Appletea404/Project_5_Balancing-Robot/images/Encoder1.JPG

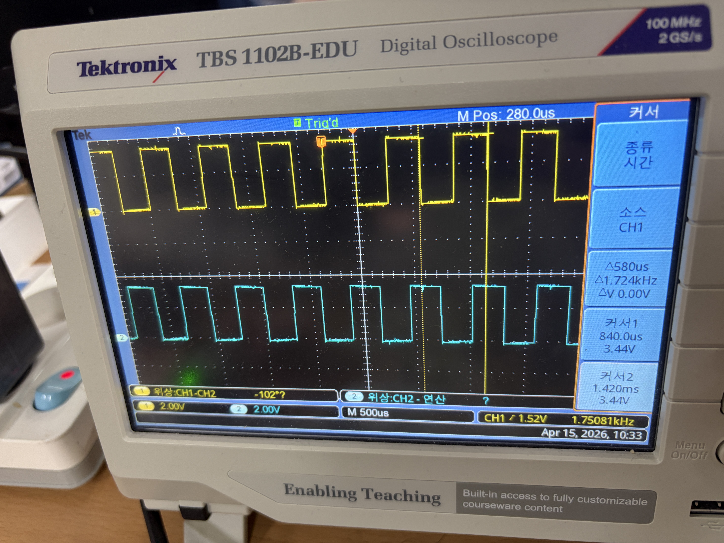
images/Encoder1.JPG
