Appletea404/Project_5_Balancing-Robot/images/Encoder2.JPG

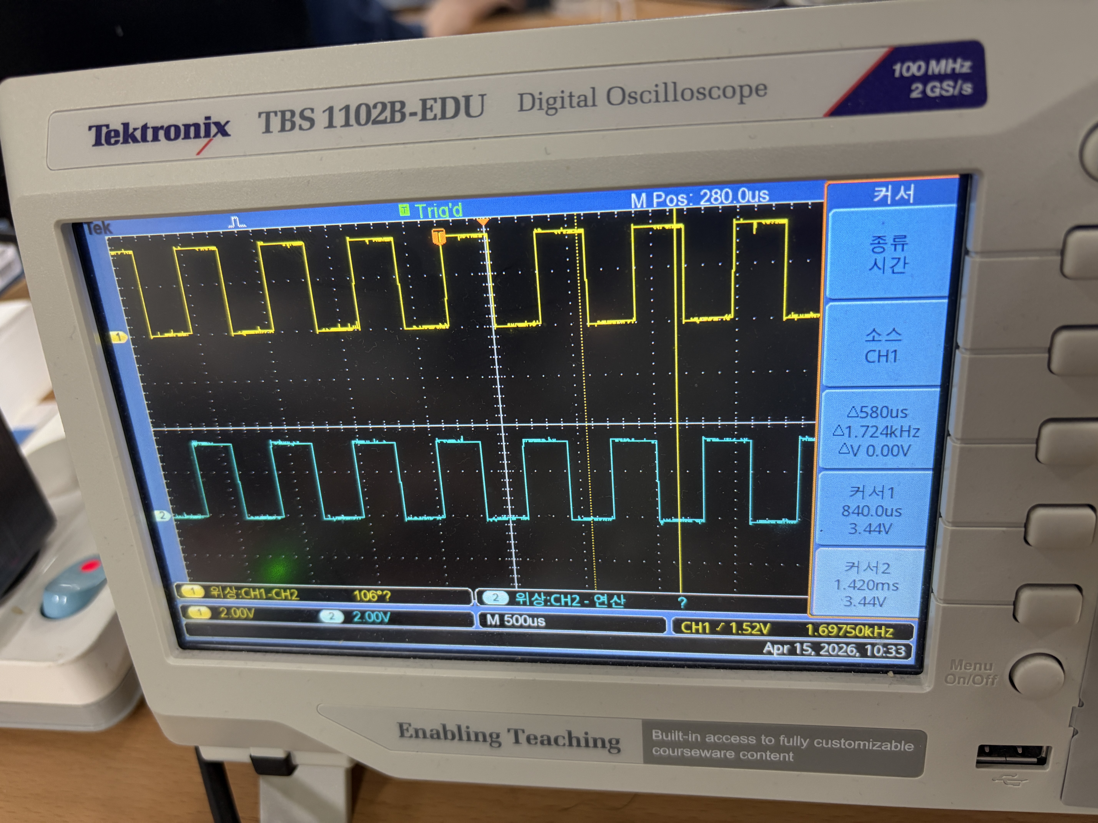
images/Encoder2.JPG
