Appletea404/Project_5_Balancing-Robot/(commit log)

2026-04-12 change basic i2c
2026-04-12 PID draft
2026-04-14 Gyro filter
2026-04-14 led to direction
2026-04-21 PID.v Adjust
