Appletea404/Project_5_Balancing-Robot/images/Motor_Driver.jpg

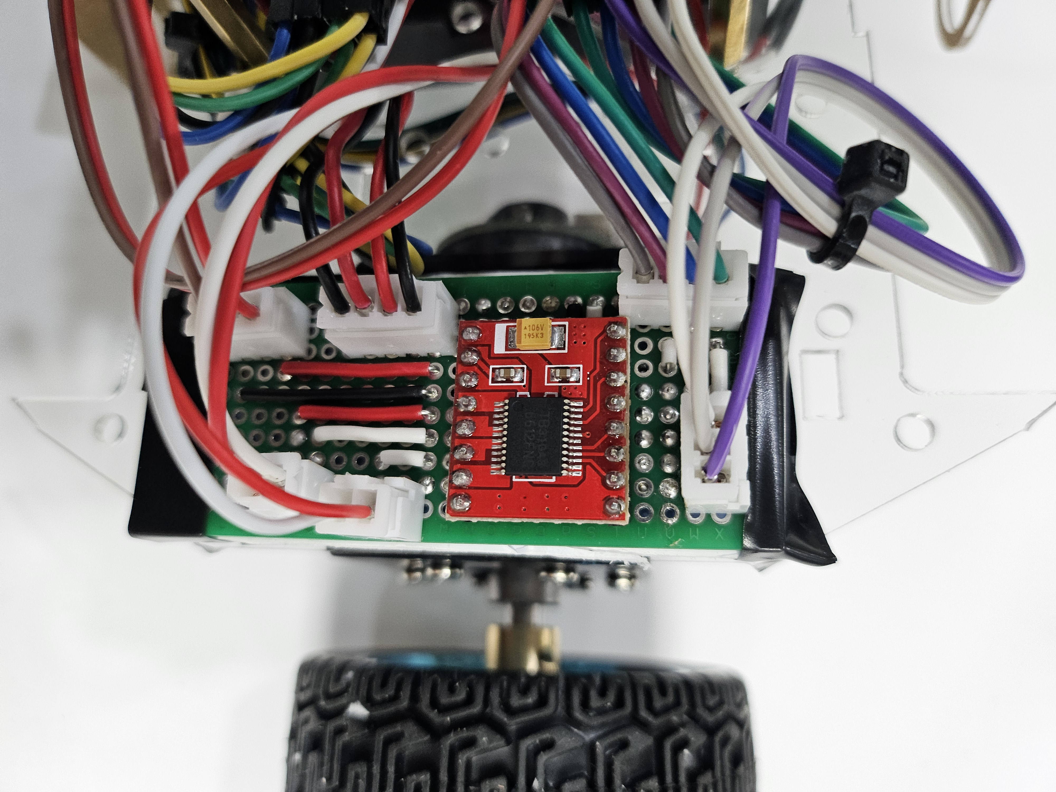
[picture p12: images/Motor_Driver.jpg]
images/Motor_Driver.jpg
